NguyenDung-203/CNC_Laser/test_gcode/dragon_180mm_lineart_preview.png

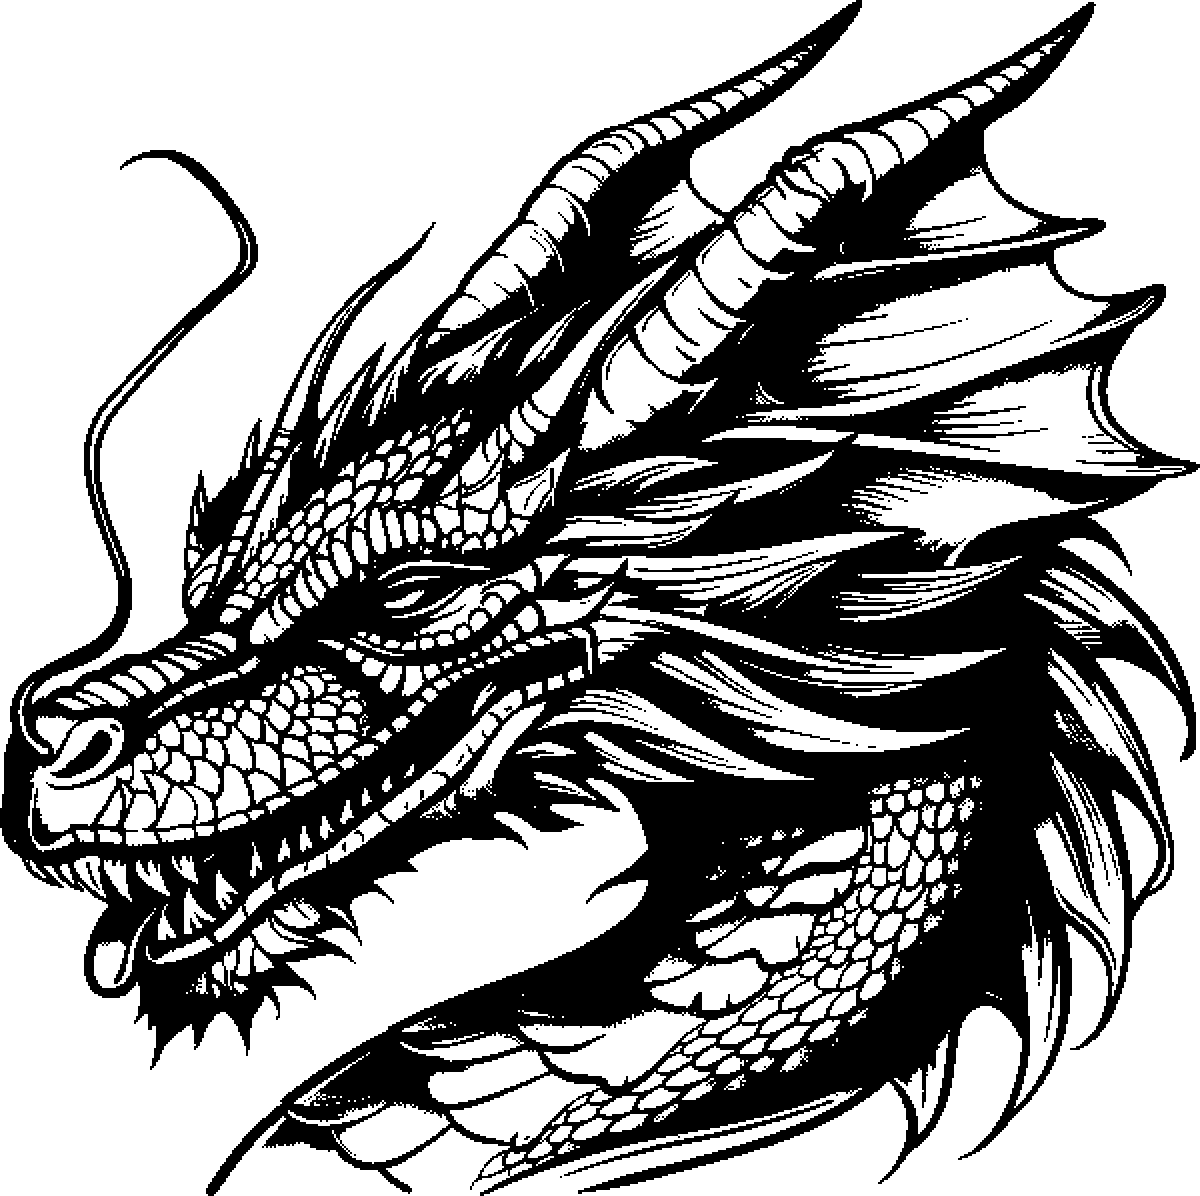
test_gcode/dragon_180mm_lineart_preview.png
