NguyenDung-203/CNC_Laser/test_gcode/hoang_dau_huyen_times_thin_80x60_preview.png

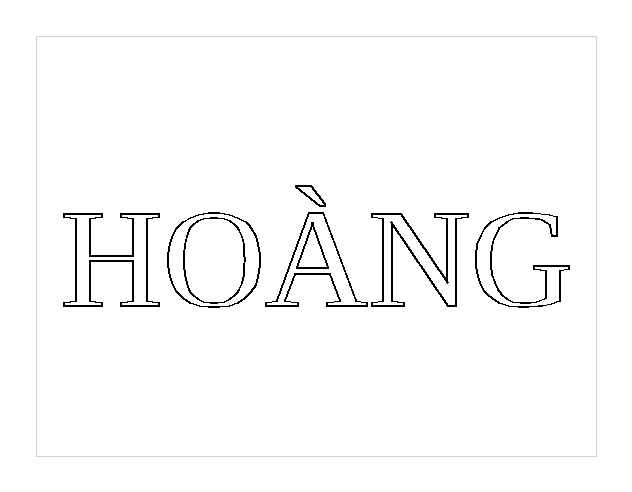
test_gcode/hoang_dau_huyen_times_thin_80x60_preview.png
