NguyenDung-203/CNC_Laser/test_gcode/son_o_horn_times_thin_80x60_preview.png

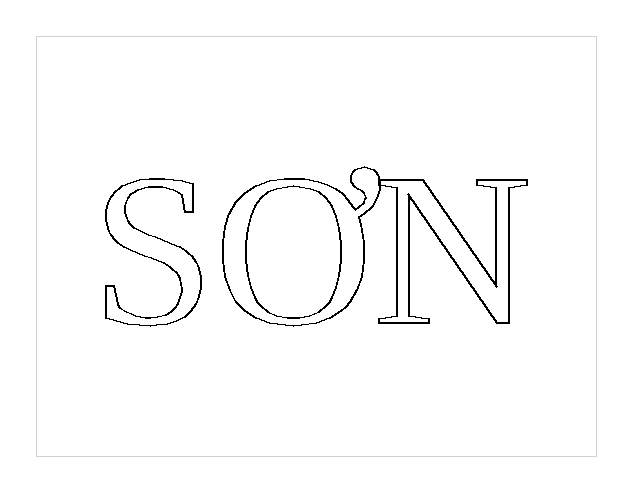
test_gcode/son_o_horn_times_thin_80x60_preview.png
