NguyenDung-203/CNC_Laser/test_gcode/ultra_complex_cyber_mandala_15mm_preview.png

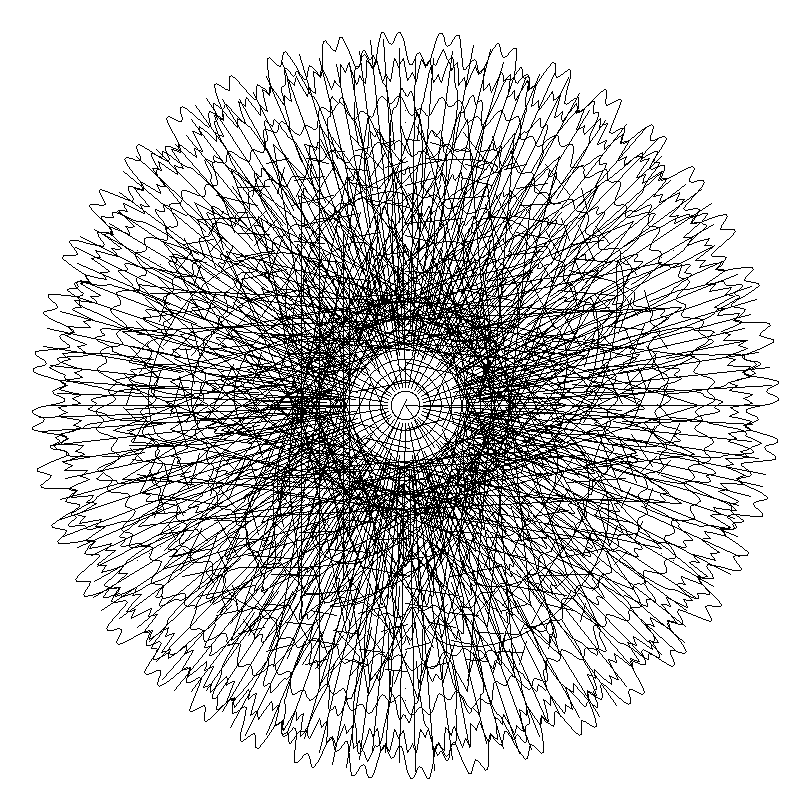
test_gcode/ultra_complex_cyber_mandala_15mm_preview.png
