NguyenDung-203/CNC_Laser/test_gcode/viet_nam_flag_150x60_preview.png

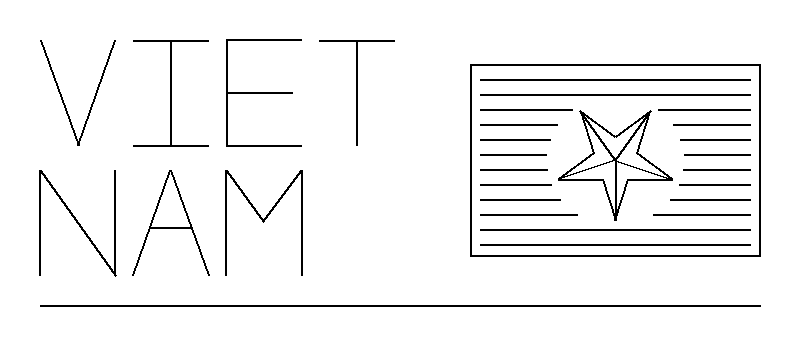
test_gcode/viet_nam_flag_150x60_preview.png
