NguyenDung-203/CNC_Laser/test_gcode/vietnam_map_sticker_80x60_preview.png

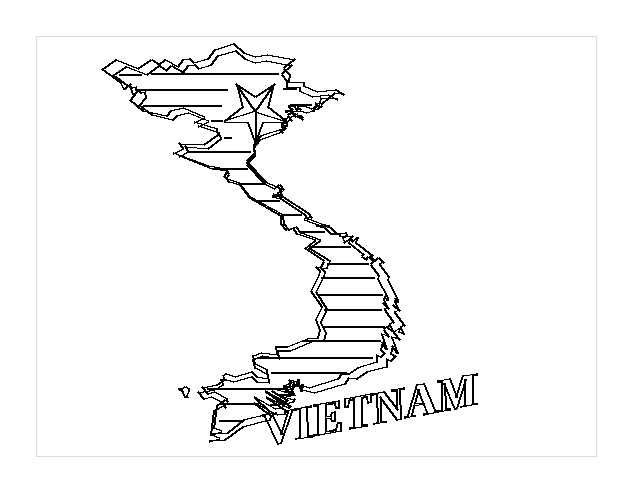
test_gcode/vietnam_map_sticker_80x60_preview.png
