NguyenDung-203/CNC_Laser/CNC_Laser_Fw/CNC_Laser_Fw.ioc

Mcu.UserName=STM32F407VETx
PA0-WKUP.GPIO_Label=EN4
PA0-WKUP.Signal=GPIO_Output
PA1.GPIO_Label=EN3
PA1.Signal=GPIO_Output
PA11.Signal=USB_OTG_FS_DM
PA12.Signal=USB_OTG_FS_DP
PA13.Signal=SYS_JTMS-SWDIO
PA14.Signal=SYS_JTCK-SWCLK
PA2.GPIO_Label=EN2
PA2.Signal=GPIO_Output
PA3.GPIO_Label=EN1
PA3.Signal=GPIO_Output
PB0.GPIO_Label=ENA2
PB0.Signal=GPIO_Output
PB1.GPIO_Label=DIR1
PB1.Signal=GPIO_Output
PB3.Signal=SPI1_SCK
PB4.Signal=SPI1_MISO
PB5.Signal=SPI1_MOSI
PB6.Signal=USART1_TX
PB7.Signal=USART1_RX
PC10.Signal=SDIO_D2
PC11.Signal=SDIO_D3
PC12.Signal=SDIO_CK
PC13-ANTI_TAMP.GPIO_Label=LED
PC13-ANTI_TAMP.Signal=GPIO_Output
PC14-OSC32_IN.Signal=RCC_OSC32_IN
PC15-OSC32_OUT.Signal=RCC_OSC32_OUT
PC4.GPIO_Label=DIR4
PC4.Signal=GPIO_Output
PC5.GPIO_Label=DIR2
PC5.Signal=GPIO_Output
PC8.Signal=SDIO_D0
PC9.Signal=SDIO_D1
PD14.GPIO_Label=LASER
PD14.Signal=GPIO_Output
PD15.GPIO_Label=MOTOR775
PD15.Signal=GPIO_Output
PD2.Signal=SDIO_CMD
PD7.GPIO_Label=SPI1_CS
PD7.Signal=GPIO_Output
PE10.GPIO_Label=ENA3
PE10.Signal=GPIO_Output
PE11.GPIO_Label=STEP4
PE11.Signal=S_TIM1_CH2
PE12.GPIO_Label=ENA4
PE12.Signal=GPIO_Output
PE13.GPIO_Label=STEP2
PE13.Signal=S_TIM1_CH3
PE14.GPIO_Label=STEP1
PE14.Signal=S_TIM1_CH4
PE15.GPIO_Label=ENA1
PE15.Signal=GPIO_Output
PE3.GPIO_Label=LIMIT1
PE3.Signal=GPIO_Input
PE4.GPIO_Label=LIMIT2
PE4.Signal=GPIO_Input
PE5.GPIO_Label=LIMIT3
PE5.Signal=GPIO_Input
PE6.GPIO_Label=LIMIT4
PE6.Signal=GPIO_Input
PE8.GPIO_Label=DIR3
PE8.Signal=GPIO_Output
PE9.GPIO_Label=STEP3
PE9.Signal=S_TIM1_CH1
PH0-OSC_IN.Signal=RCC_OSC_IN
PH1-OSC_OUT.Signal=RCC_OSC_OUT
