NguyenDung-203/CNC_Laser/tools/esp32_uart_bridge/esp32_uart_bridge.ino

/*
 * ESP32 CNC Laser bridge source is maintained in:
 *
 *   src/main.cpp
 *
 * Build/upload with PlatformIO:
 *
 *   ~/.platformio/penv/bin/pio run -e esp32dev_usb -t upload
 *   ~/.platformio/penv/bin/pio run -e esp32dev_ota -t upload
 */
