NguyenDung-203/CNC_Laser/(notices)

Notices in the files:
CNC_Laser_Fw/Core/Src/main.c:
Copyright (c) 2026 STMicroelectronics.
All rights reserved.
This software is licensed under terms that can be found in the LICENSE file
